Danjovic/Outragian_Clock/doc/AllDisplays.png

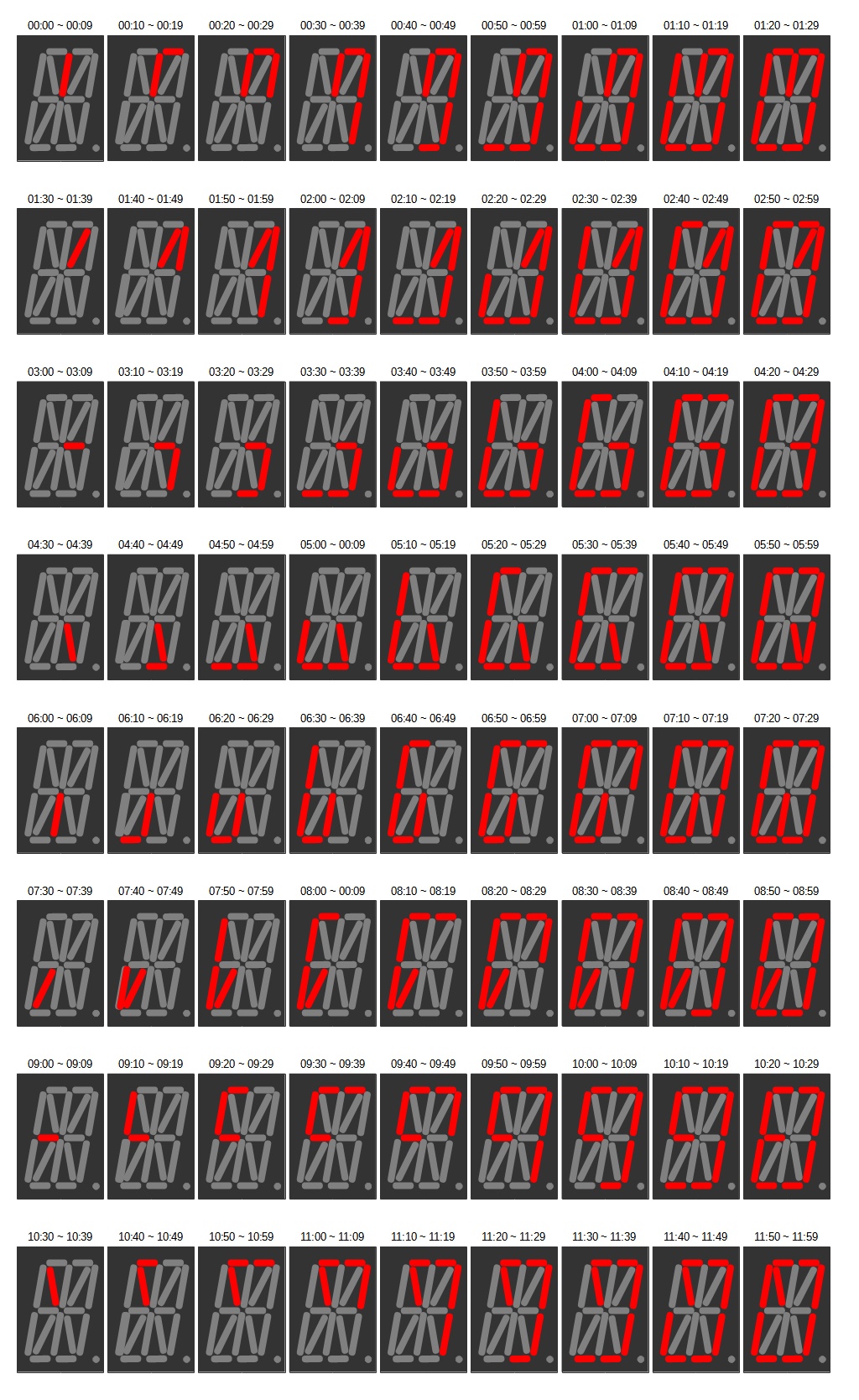
doc/AllDisplays.png
