Danjovic/Outragian_Clock/doc/base.png

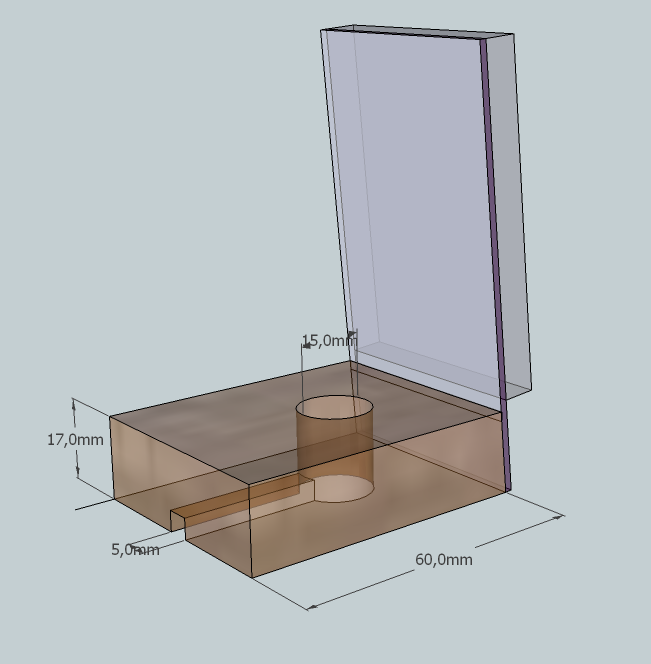
doc/base.png
