Danjovic/Outragian_Clock/doc/buttons.png

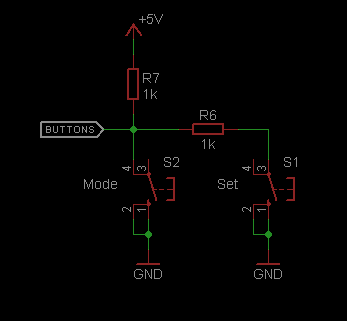
doc/buttons.png
