Danjovic/Outragian_Clock/doc/circuit.png

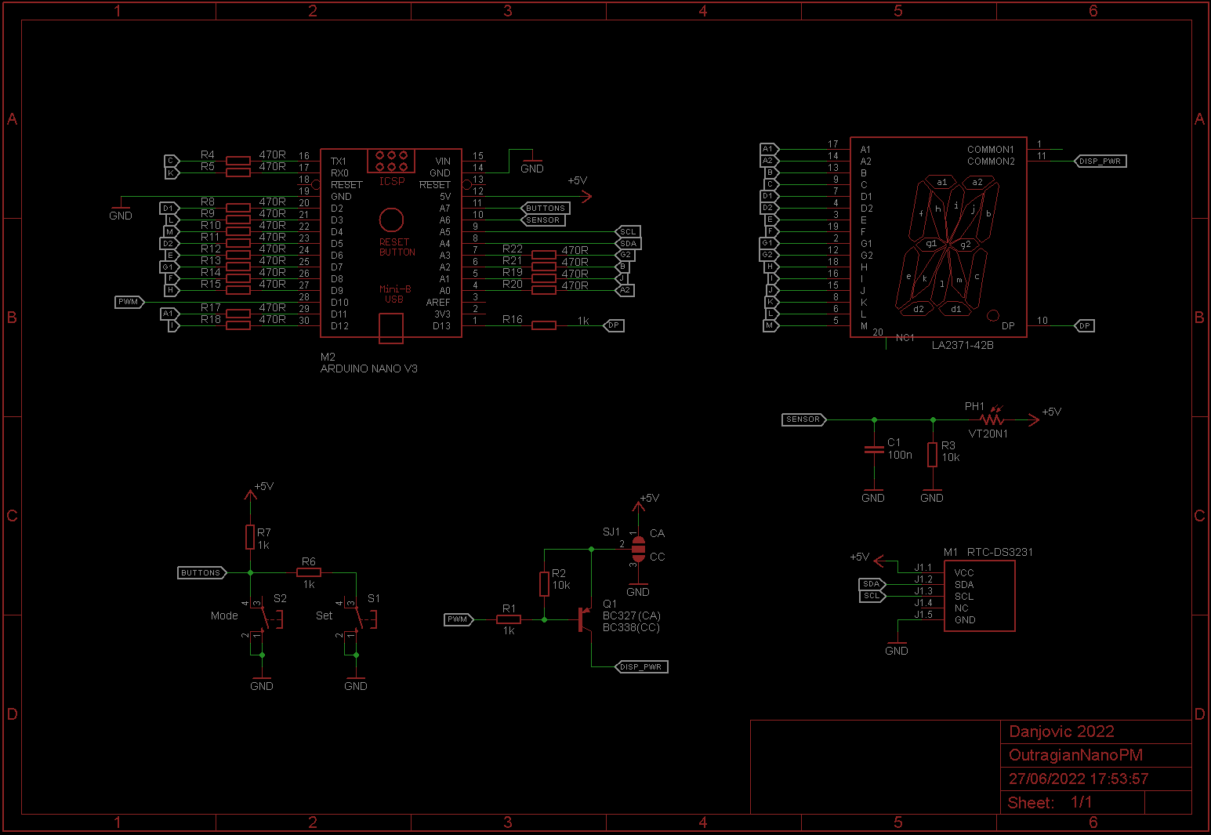
doc/circuit.png
