Danjovic/Outragian_Clock/doc/circuito.png

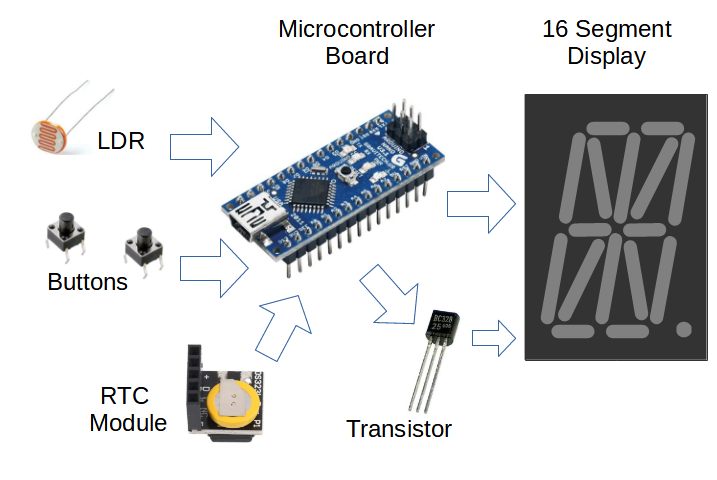
doc/circuito.png
