Danjovic/Outragian_Clock/doc/cycle.png

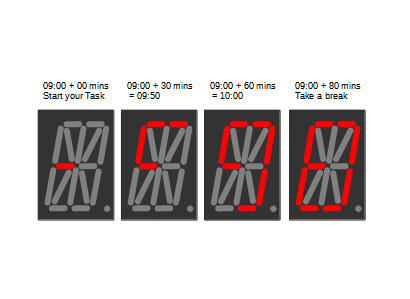
doc/cycle.png
