Danjovic/Outragian_Clock/doc/firstinterval.png

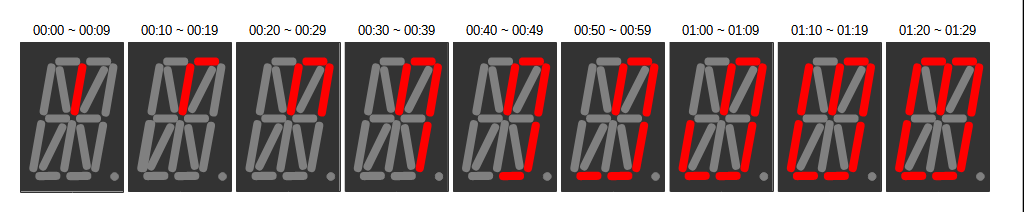
doc/firstinterval.png
