Danjovic/Outragian_Clock/doc/inner.png

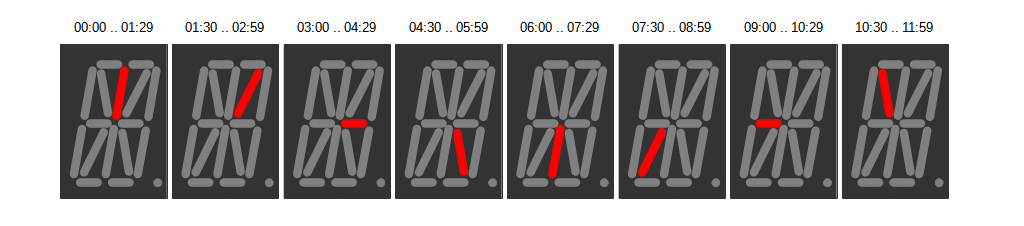
doc/inner.png
