Danjovic/Outragian_Clock/doc/ldr sense.png

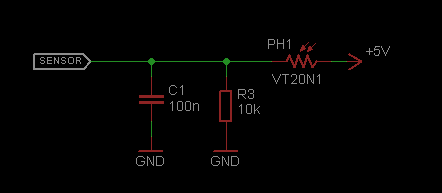
doc/ldr sense.png
