Danjovic/Outragian_Clock/doc/pwm.png

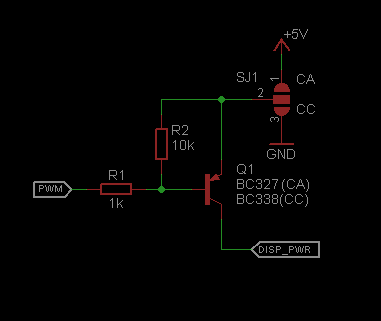
doc/pwm.png
