Danjovic/Outragian_Clock/doc/render.png

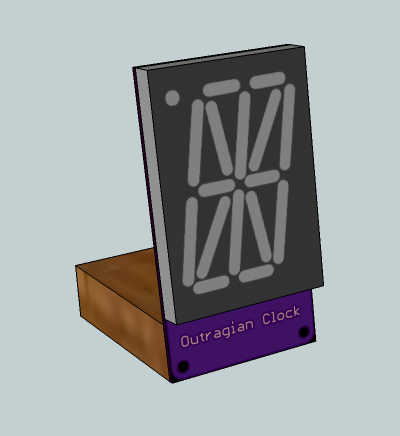
doc/render.png
