Danjovic/Outragian_Clock/doc/state machine.png

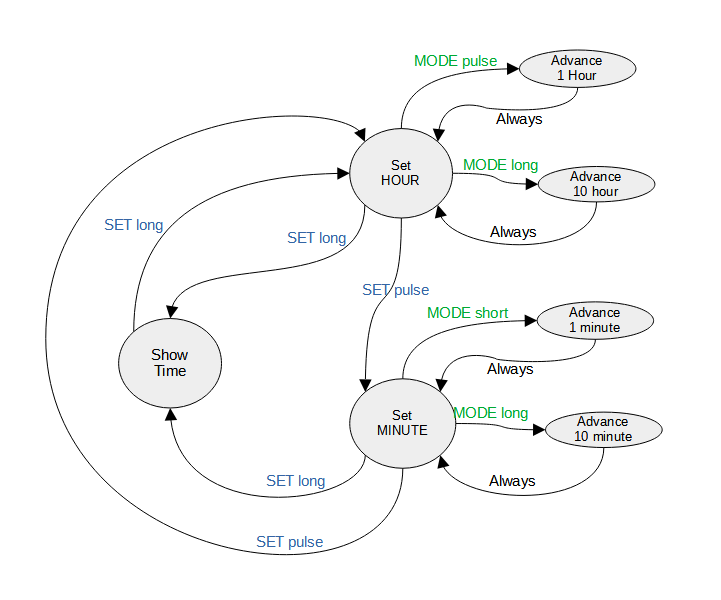
doc/state machine.png
