Danjovic/Outragian_Clock/circuit/OutragianNanoPM.brd

## EAGLE design circuit/OutragianNanoPM.brd (2022-10-17)

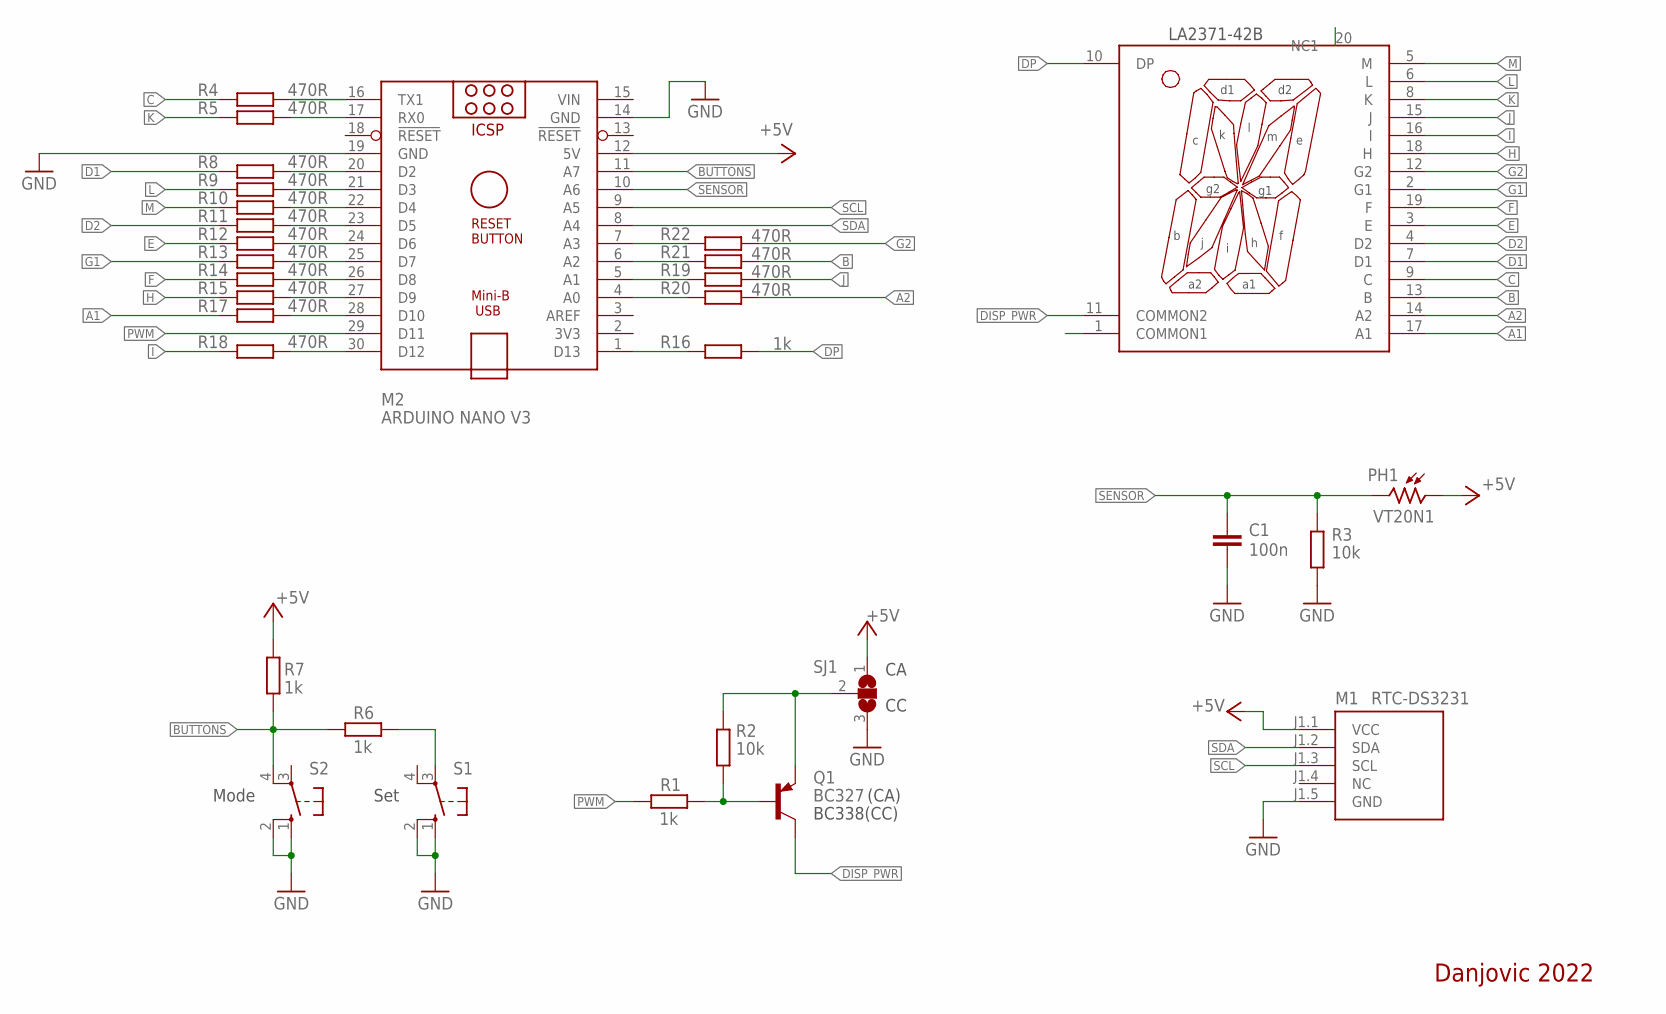
[picture p13: schematic OutragianNanoPM.sch]

Parts:
C1: 100n; C050-024X044L
DS1: LA2371-42B; LA(C)2371-42B-M1
M1: RTC-DS3231; RTC-DS3231_SMALL
M2: ARDUINO NANO V3; ARDUINO_NANO
PH1: VT20N1; TO46-VT200
Q1: BC327; TO92-EBC
R1, R6, R7, R16: 1k; 0204/7L
R2, R3: 10k; 0204/7L
R4, R5, R8, R9, R10, R11, R12, R13, R14, R15, R17, R18, R19, R20, R21, R22: 470R; 0204/7L
S1, S2: 10-XX; B3F-10XX
SJ1: SJ2W; SJ_2

Connections:
+5V: M1.J1.1 (VCC), M2.12 (5V), PH1.1, R7.1, SJ1.1
A1: DS1.17 (A1), R17.2
A2: DS1.14 (A2), R20.2
B: DS1.13 (B), R21.2
BUTTONS: M2.11 (A7), R6.2, R7.2, S2.4 (P1)
C: DS1.9 (C), R4.1
D1: DS1.7 (D1), R8.1
D2: DS1.4 (D2), R11.1
DDP: M2.1 (D13), R16.1
DISP_PWR: DS1.11 (COMMON2), Q1.C
DISP_PWR2: DS1.1 (COMMON1)
DP: DS1.10 (DP), DS1.20 (NC1), R16.2
E: DS1.3 (E), R12.1
F: DS1.19 (F), R14.2
G1: DS1.2 (G1), R13.1
G2: DS1.12 (G2), R22.2
GND: C1.2, M1.J1.5 (GND), M2.14 (GND), M2.19 (GND), R3.1, S1.1 (S), S1.2 (S1), S2.1 (S), S2.2 (S1), SJ1.3
H: DS1.18 (H), R15.2
I: DS1.16 (I), R18.2
J: DS1.15 (J), R19.2
K: DS1.8 (K), R5.1
L: DS1.6 (L), R9.1
M: DS1.5 (M), R10.1
unnamed: Q1.B, R1.2, R2.2
unnamed: M2.7 (A3), R22.1
unnamed: R6.1, S1.3
unnamed: M2.26 (D8), R14.1
unnamed: M2.6 (A2), R21.1
unnamed: Q1.E, R2.1, SJ1.2
unnamed: M2.5 (A1), R19.1
unnamed: M2.4 (A0), R20.1
unnamed: M2.27 (D9), R15.1
unnamed: M2.28 (D10), R17.1
unnamed: M2.30 (D12), R18.1
unnamed: M2.25 (D7), R13.2
unnamed: M2.24 (D6), R12.2
unnamed: M2.23 (D5), R11.2
unnamed: M2.22 (D4), R10.2
unnamed: M2.21 (D3), R9.2
unnamed: M2.20 (D2), R8.2
unnamed: M2.17 (RX0), R5.2
unnamed: M2.16 (TX1), R4.2
PWM: M2.29 (D11), R1.1
SCL: M1.J1.3 (SCL), M2.9 (A5)
SDA: M1.J1.2 (SDA), M2.8 (A4)
SENSOR: C1.1, M2.10 (A6), PH1.2, R3.2
VIN: M2.15 (VIN)

Notes on the sheet:
Mode
Set
LA2371-42B
Danjovic 2022
(CA)
BC338(CC)

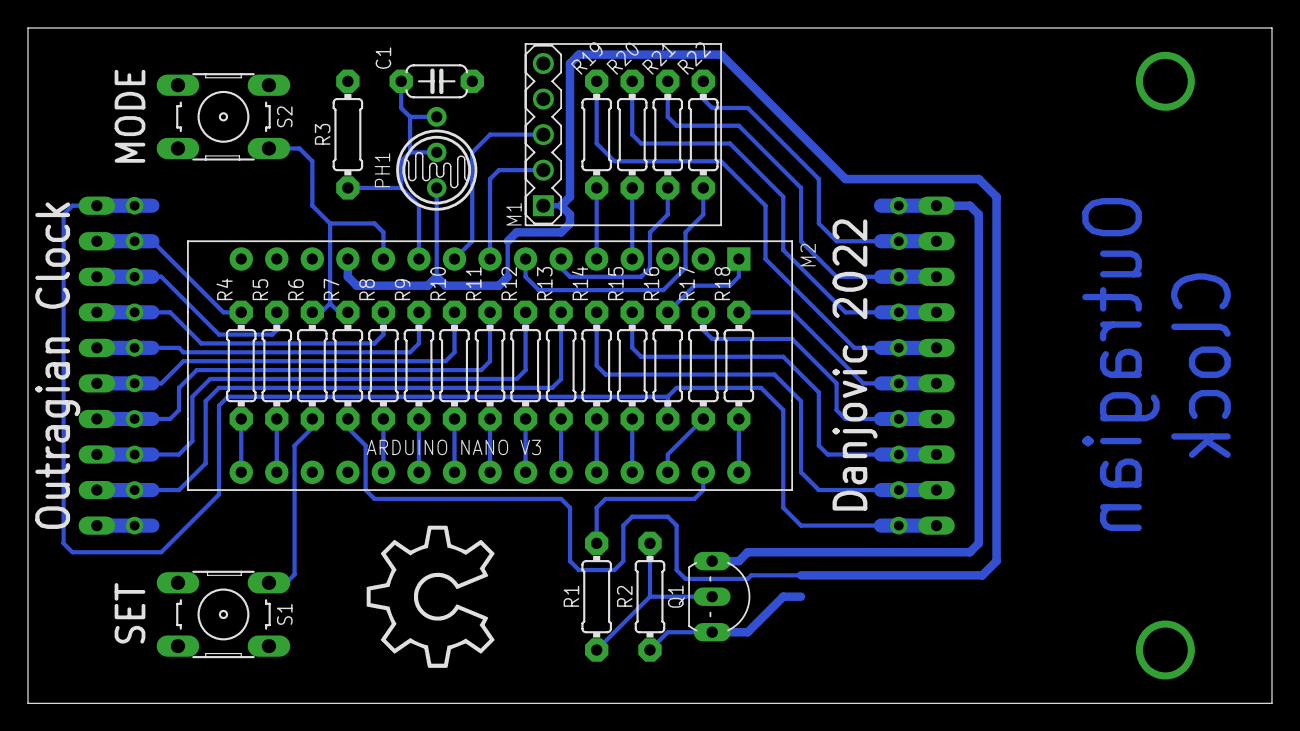
[picture p14: board OutragianNanoPM.brd from above]

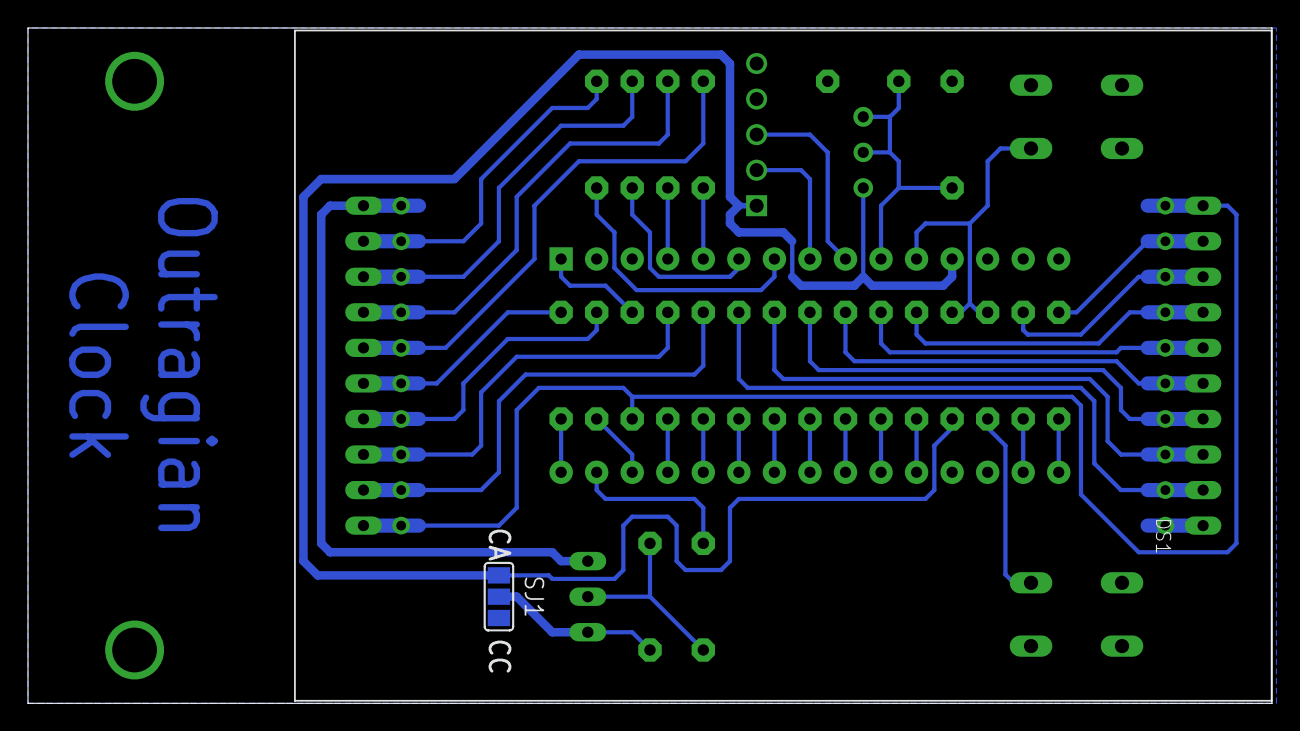
[picture p15: board OutragianNanoPM.brd from below]

Board: 2 copper layers, 88.9 x 48.3 mm, 31 parts (2 on the bottom side), 45 nets.
